Lee-F-Evans/Garden-Control-System/parts/1992Series5Specs.webp

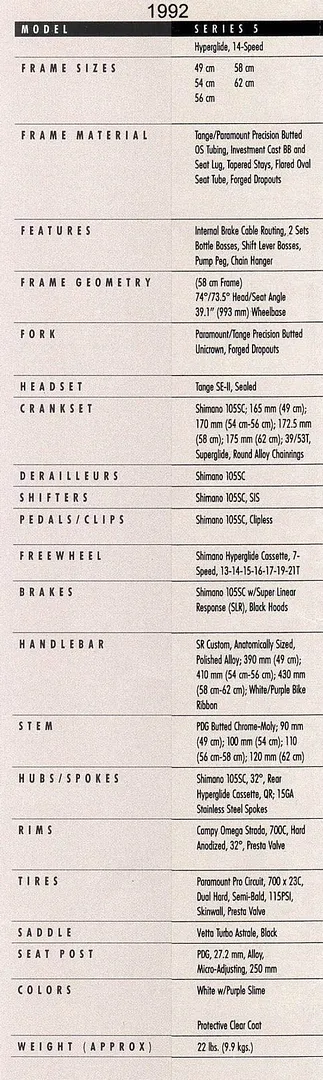
parts/1992Series5Specs.webp
