Lee-F-Evans/Garden-Control-System/3.3V buck LMR36520A.png

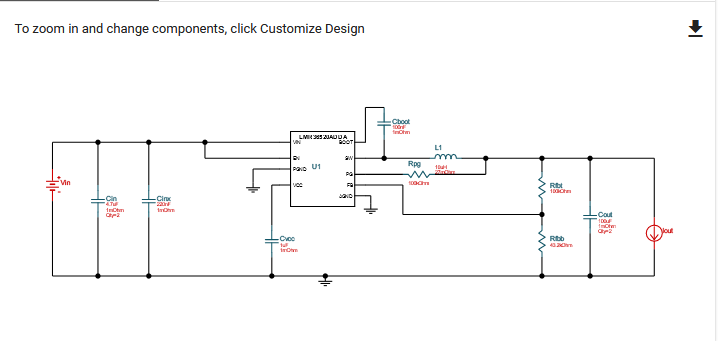
3.3V buck LMR36520A.png
