Lee-F-Evans/Garden-Control-System/3v0 ldo tps7A7001.png

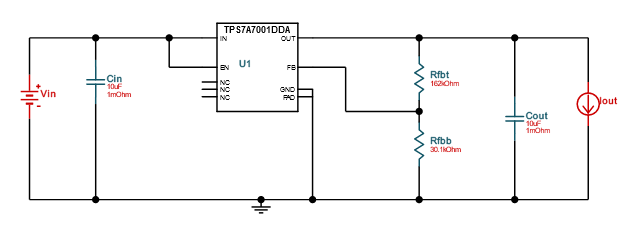
3v0 ldo tps7A7001.png
