Lee-F-Evans/Garden-Control-System/3V0 LDO TPS74901.png

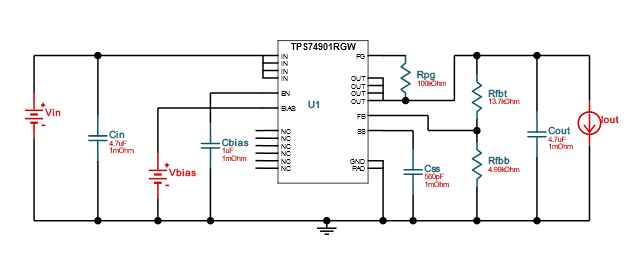
3V0 LDO TPS74901.png
