Lee-F-Evans/Garden-Control-System/LDO typical circuit.png

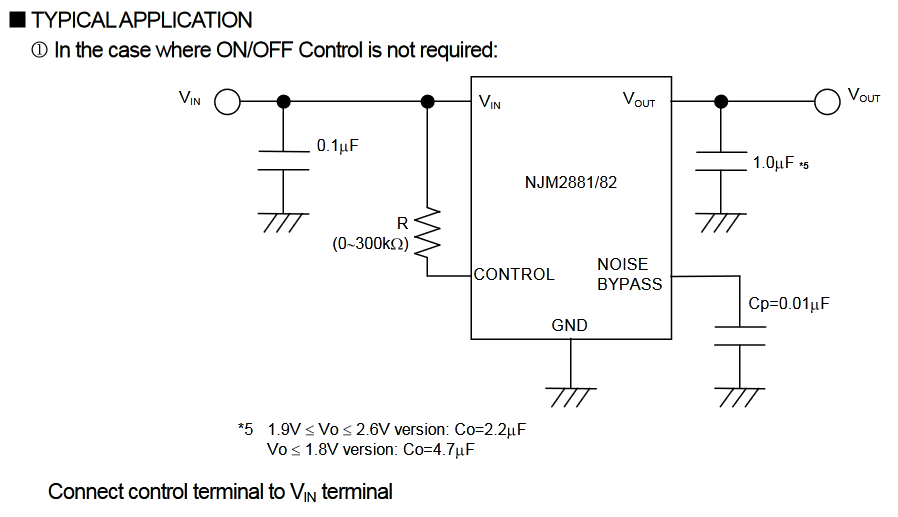
LDO typical circuit.png
