Lee-F-Evans/Garden-Control-System/LED RESISTOR VALUES FOR STRAPPING.png

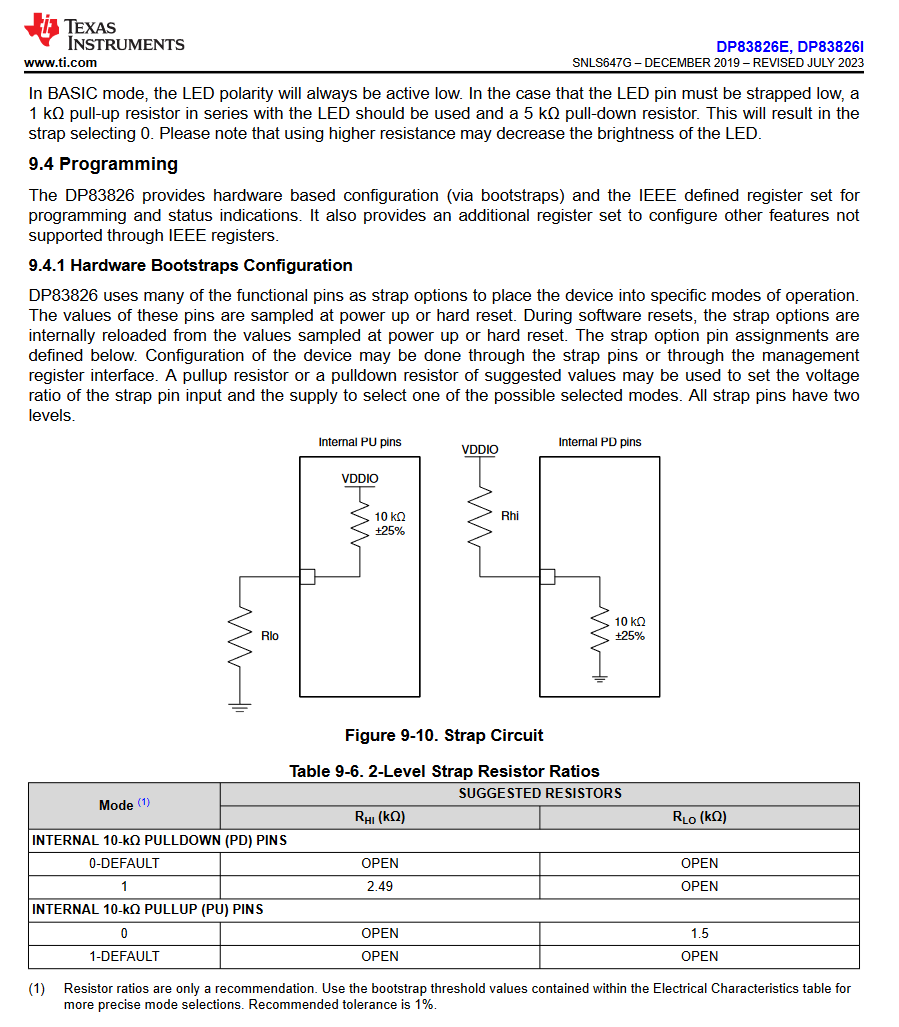
LED RESISTOR VALUES FOR STRAPPING.png
