Lee-F-Evans/Garden-Control-System/MCU_STM32F20x power info.png

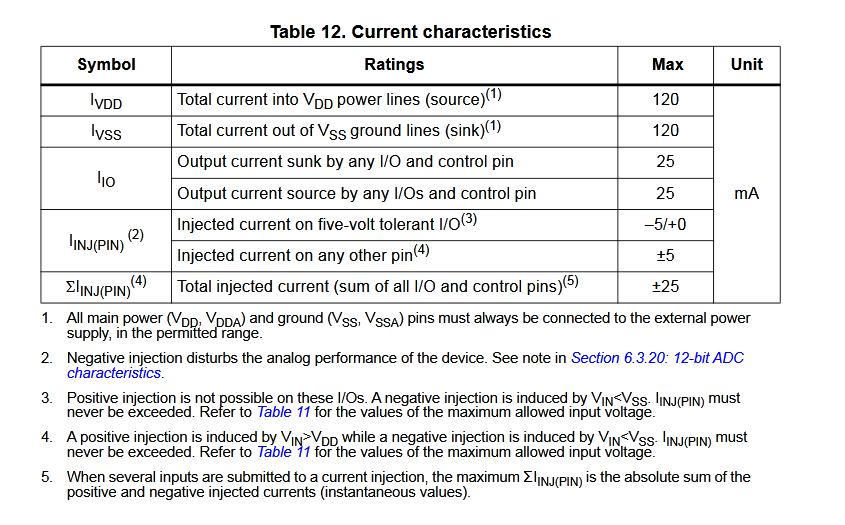
MCU_STM32F20x power info.png
