Lee-F-Evans/Garden-Control-System/MCU_STM32F205RG_pinout.png

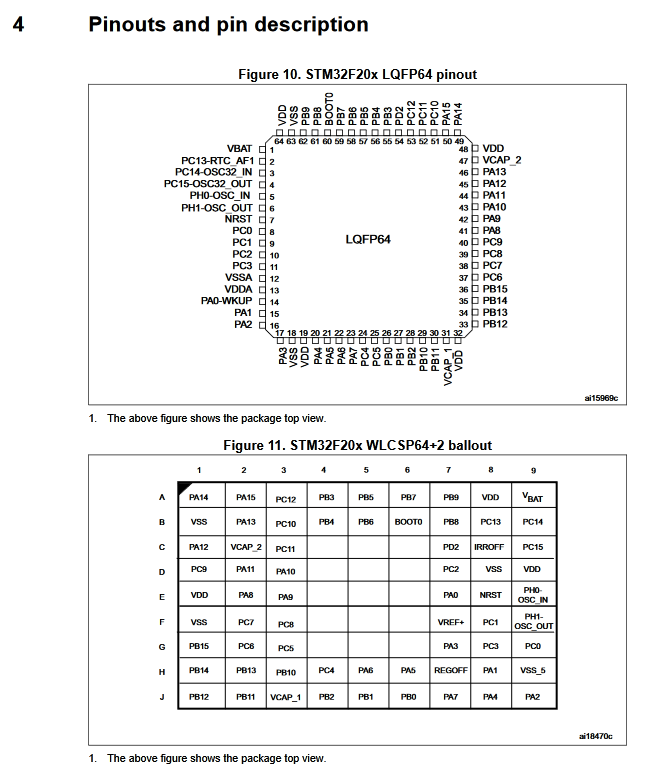
MCU_STM32F205RG_pinout.png
