Lee-F-Evans/Garden-Control-System/PHY strapping.png

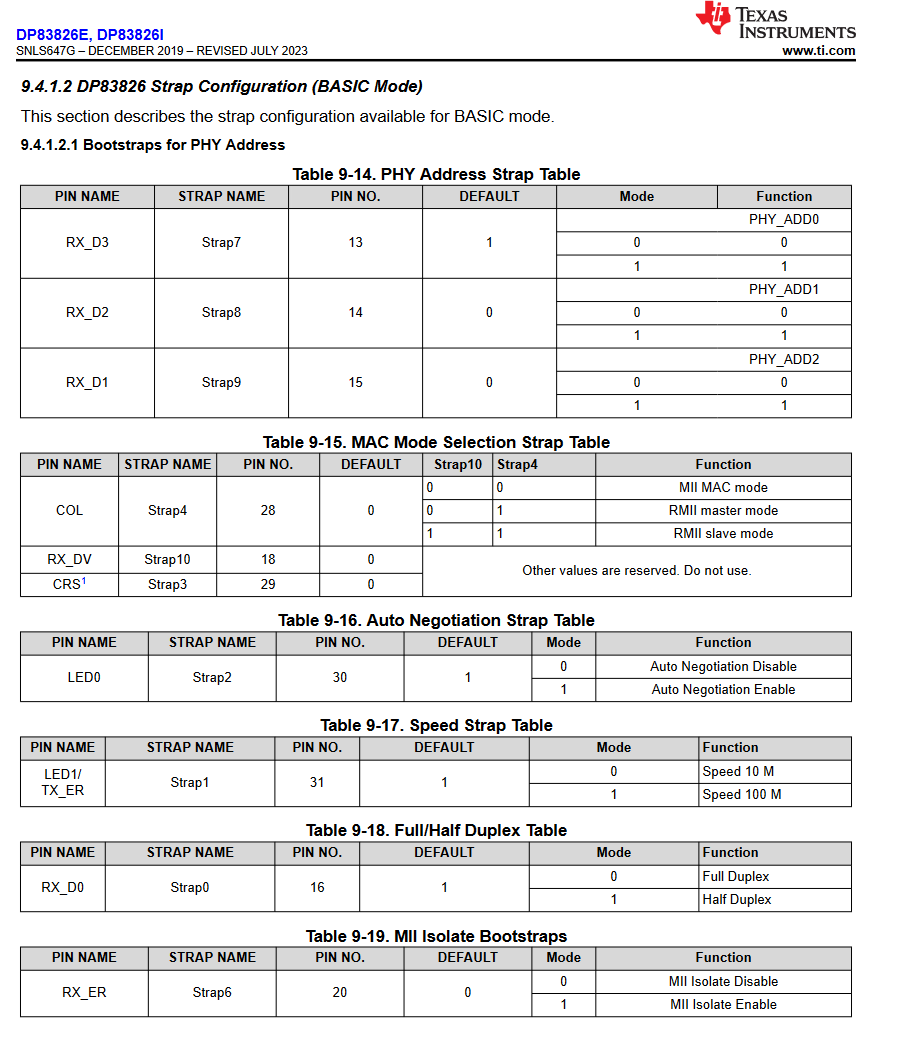
PHY strapping.png
