Lee-F-Evans/Garden-Control-System/Screenshot 2024-05-06 075731.png

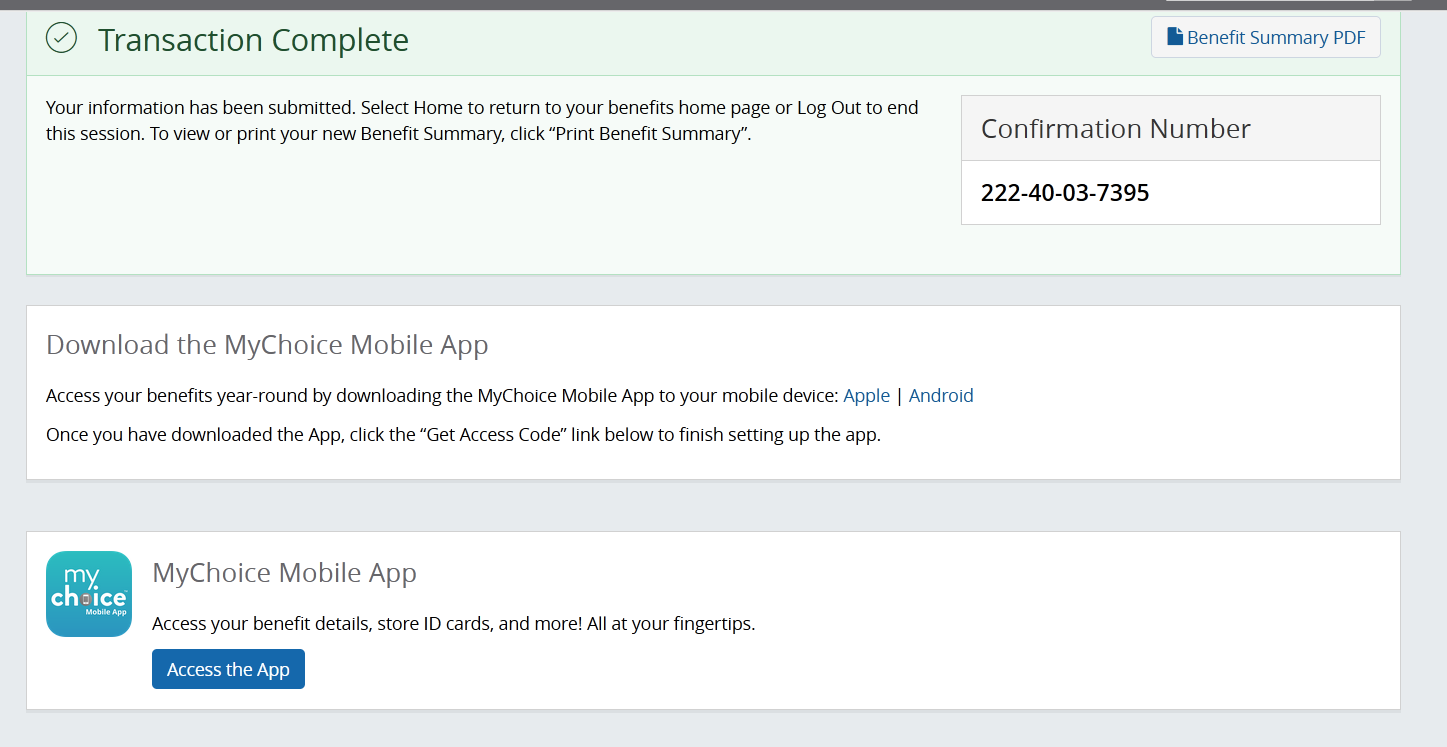
Screenshot 2024-05-06 075731.png
