Lee-F-Evans/Garden-Control-System/BOM.xlsx

1206, 100nF cap | https://www.digikey.ca/en/products/detail/samsung-electro-mechanics/CL31B104KBCNNNC/3886675
1206, 0.01uF cap | https://www.digikey.ca/en/products/detail/kemet/C1206C103KCRAC7800/721283
1206, 1uF cap | https://www.digikey.ca/en/products/detail/samsung-electro-mechanics/CL31B105KBHNNNE/3886726
1206 3KOhm resistor | https://www.digikey.ca/en/products/detail/yageo/RC1206FR-07300KL/728805
1206 ferrite bead | https://www.digikey.ca/en/products/detail/laird-signal-integrity-products/HI1206T500R-10/806649
