Lee-F-Evans/Garden-Control-System/parts/12V_5A_BarrelJack_pj-102ah/PJ-102AH.step

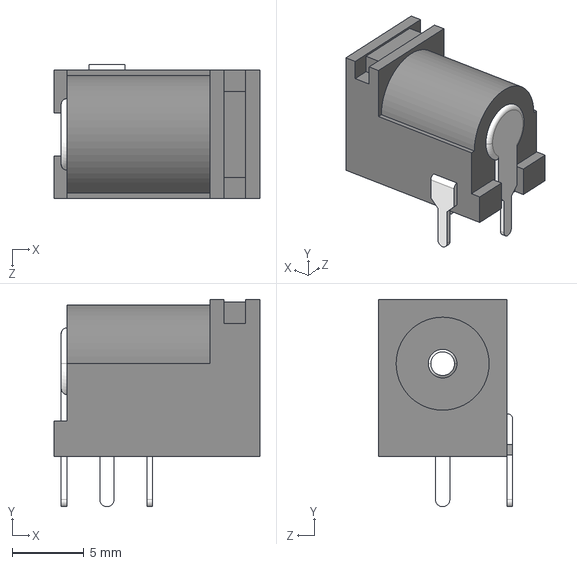
[picture p13: CAD file, 2024-04-08]
parts/12V_5A_BarrelJack_pj-102ah/PJ-102AH.step
14.4 x 14.5 x 9.40 mm
