Lee-F-Evans/Garden-Control-System/parts/3V3 LDO TPS7A7001DDAR/TPS7A7001DDAR.step

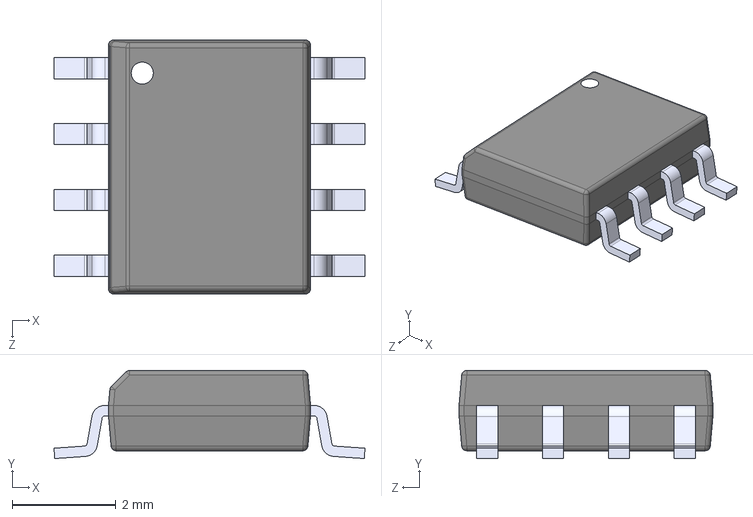
[picture p14: CAD file, 2024-04-23]
parts/3V3 LDO TPS7A7001DDAR/TPS7A7001DDAR.step
6.00 x 1.70 x 4.90 mm
