Lee-F-Evans/Garden-Control-System/parts/MCU_CRYSTAL_ECS_160_8_37_CWY_TR3/ECS-160-8-37-CWY-TR3.step

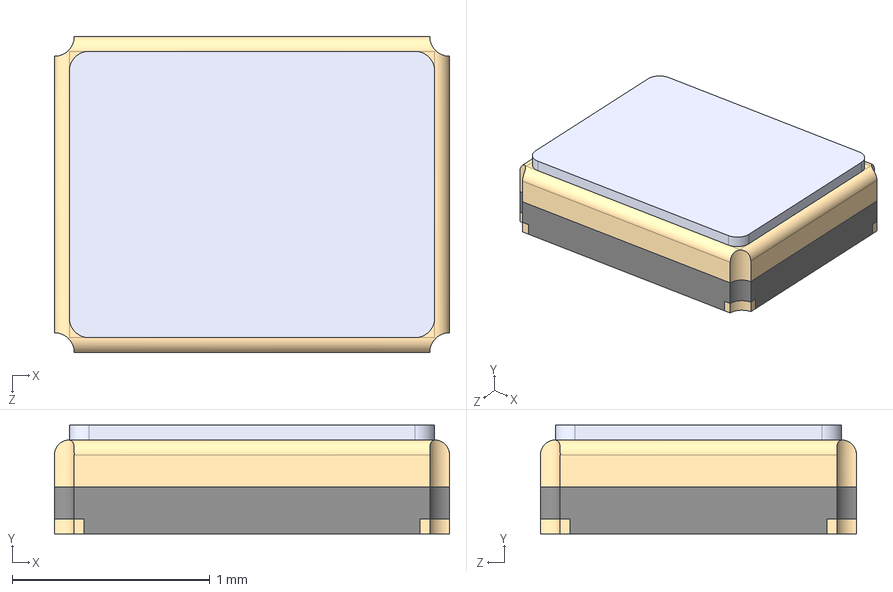
[picture p15: CAD file, 2024-04-08]
parts/MCU_CRYSTAL_ECS_160_8_37_CWY_TR3/ECS-160-8-37-CWY-TR3.step
2.00 x 0.55 x 1.60 mm
