Lee-F-Evans/Garden-Control-System/parts/MOTOR_DRIVER_DRV8848PWPR/DRV8848PWPR.step

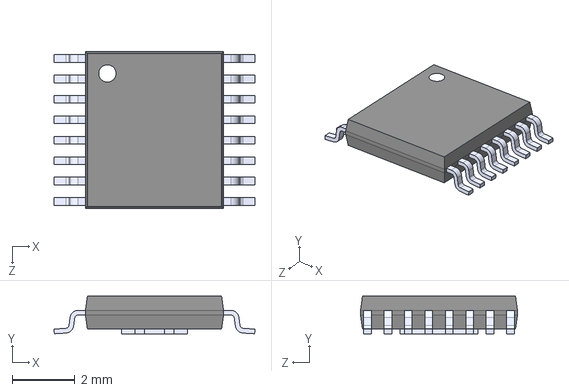
[picture p16: CAD file, 2024-04-08]
parts/MOTOR_DRIVER_DRV8848PWPR/DRV8848PWPR.step
6.40 x 1.20 x 5.00 mm
