Lee-F-Evans/Garden-Control-System/parts/PHY_CRYSTAL_ECS_250_20_33_TR/ECS-250-20-33-TR.step

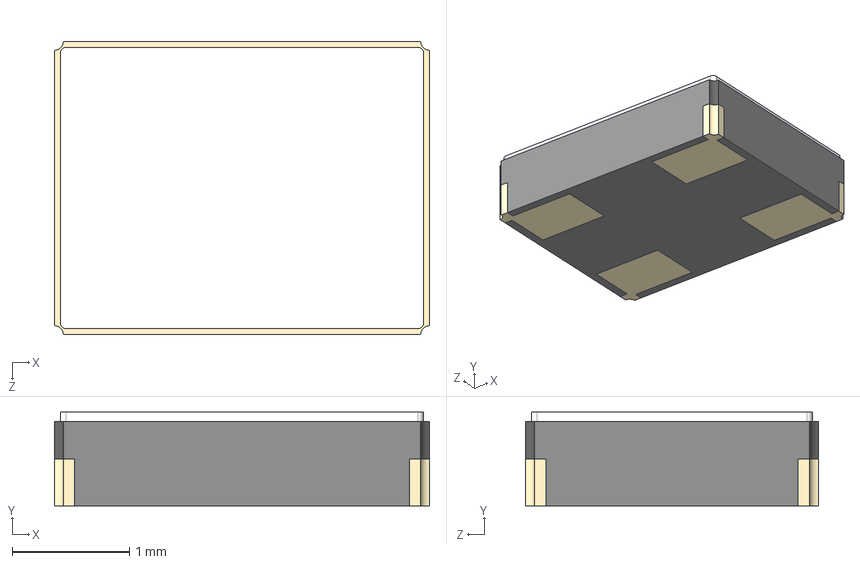
[picture p17: CAD file, 2024-04-08]
parts/PHY_CRYSTAL_ECS_250_20_33_TR/ECS-250-20-33-TR.step
3.20 x 0.8 x 2.50 mm
