Lee-F-Evans/Garden-Control-System/parts/POWER_NMOS_IRLML6344TRPBF/IRLML6344TRPBF.step

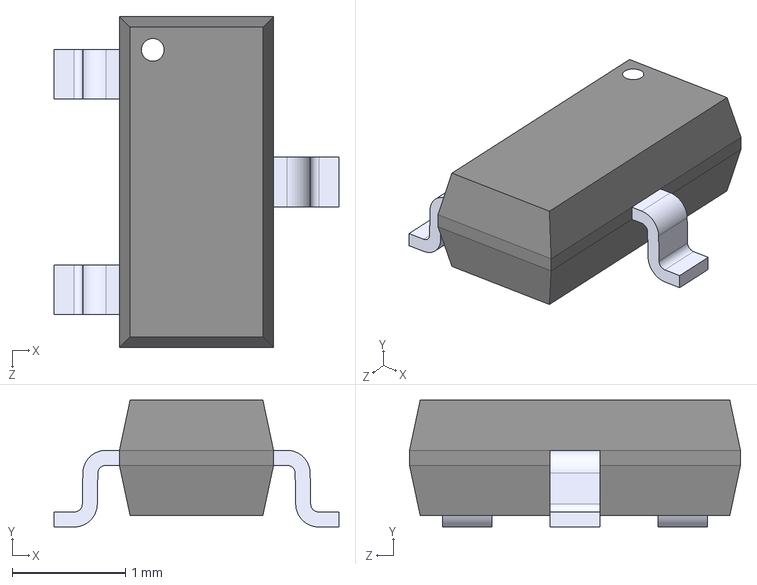
[picture p18: CAD file, 2024-04-09]
parts/POWER_NMOS_IRLML6344TRPBF/IRLML6344TRPBF.step
2.51 x 1.12 x 2.92 mm
