Lee-F-Evans/Garden-Control-System/parts/RJ45_RJHSE_5084/RJHSE-5084.step

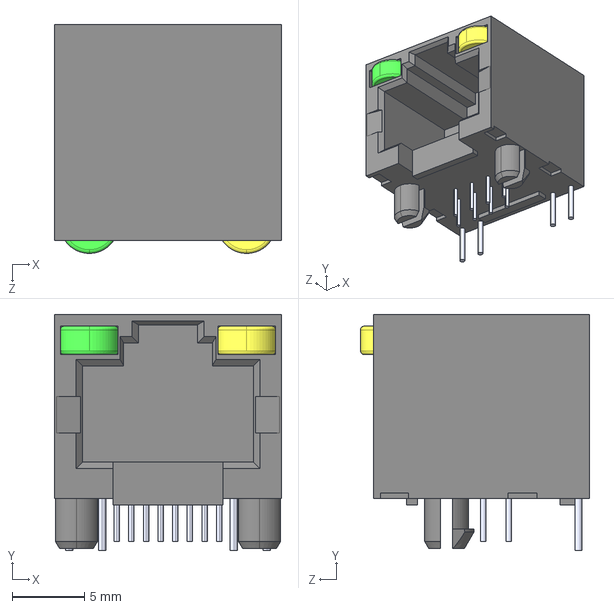
[picture p19: CAD file, 2024-04-08]
parts/RJ45_RJHSE_5084/RJHSE-5084.step
15.7 x 16.4 x 15.9 mm
