Lee-F-Evans/Garden-Control-System/parts/5V BUCK TPS54202HDDCR/TPS54202HDDCR.step

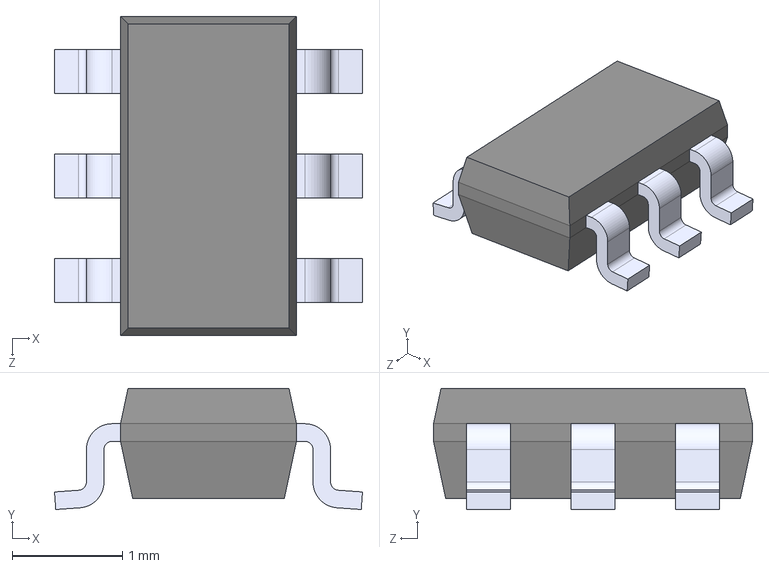
[picture p20: CAD file, 2024-04-23]
parts/5V BUCK TPS54202HDDCR/TPS54202HDDCR.step
2.80 x 1.10 x 2.90 mm
