Lee-F-Evans/Garden-Control-System/parts/PHY_DP83826IRHBR/DP83826IRHBR.step

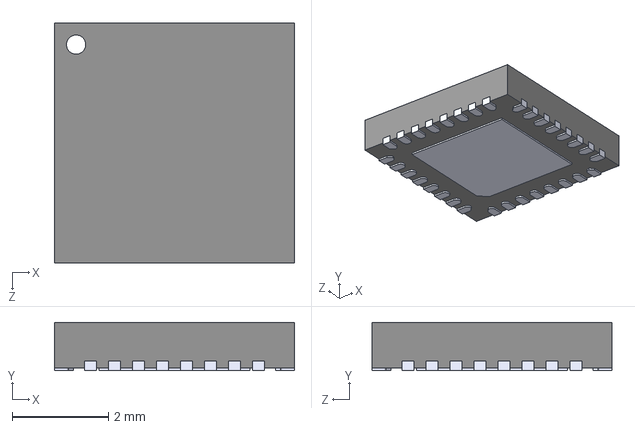
[picture p21: CAD file, 2024-04-08]
parts/PHY_DP83826IRHBR/DP83826IRHBR.step
5.00 x 1.00 x 5.00 mm
