Lee-F-Evans/Garden-Control-System/(list of files, cad)

Other CAD files:
parts/CUR_SENSE_INA4180A2IPWR/Concept/2024_04_08_20_24_48/exported/ina4180a2ipwr/chips/chips.prt
