Lee-F-Evans/Garden-Control-System/PHY and MAG wiring diagram.png

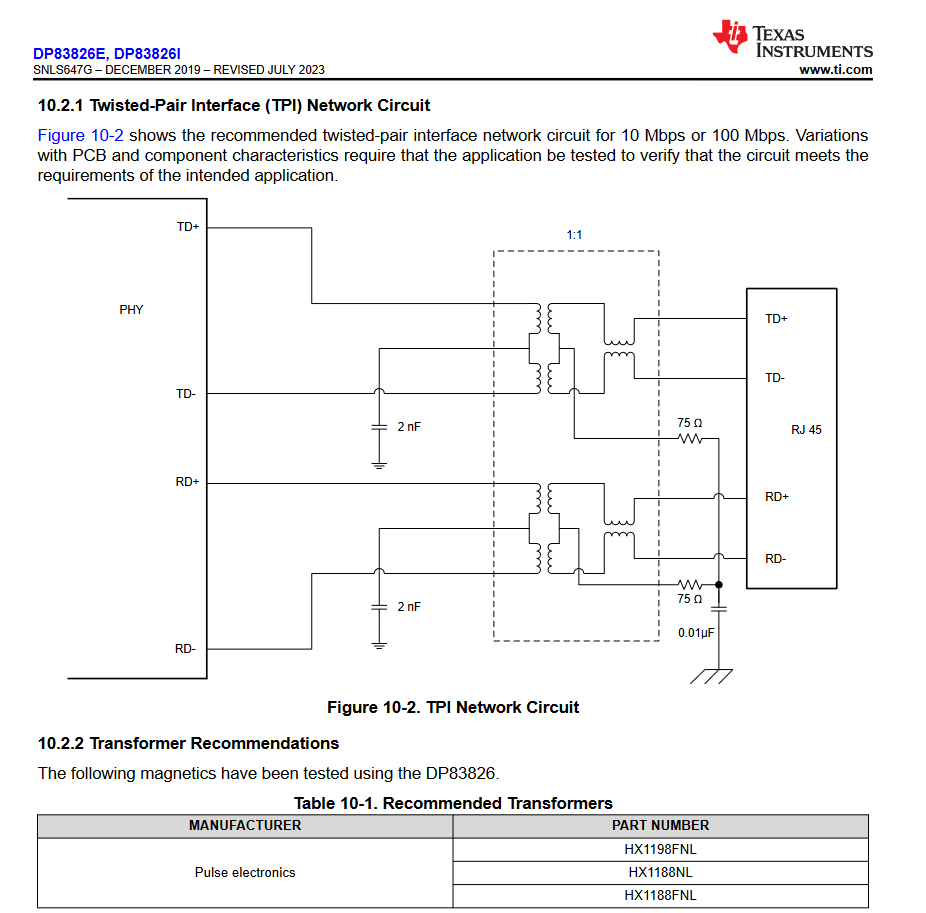
PHY and MAG wiring diagram.png
