Lee-F-Evans/Garden-Control-System/parts/RJ45_RJHSE-5084.pdf

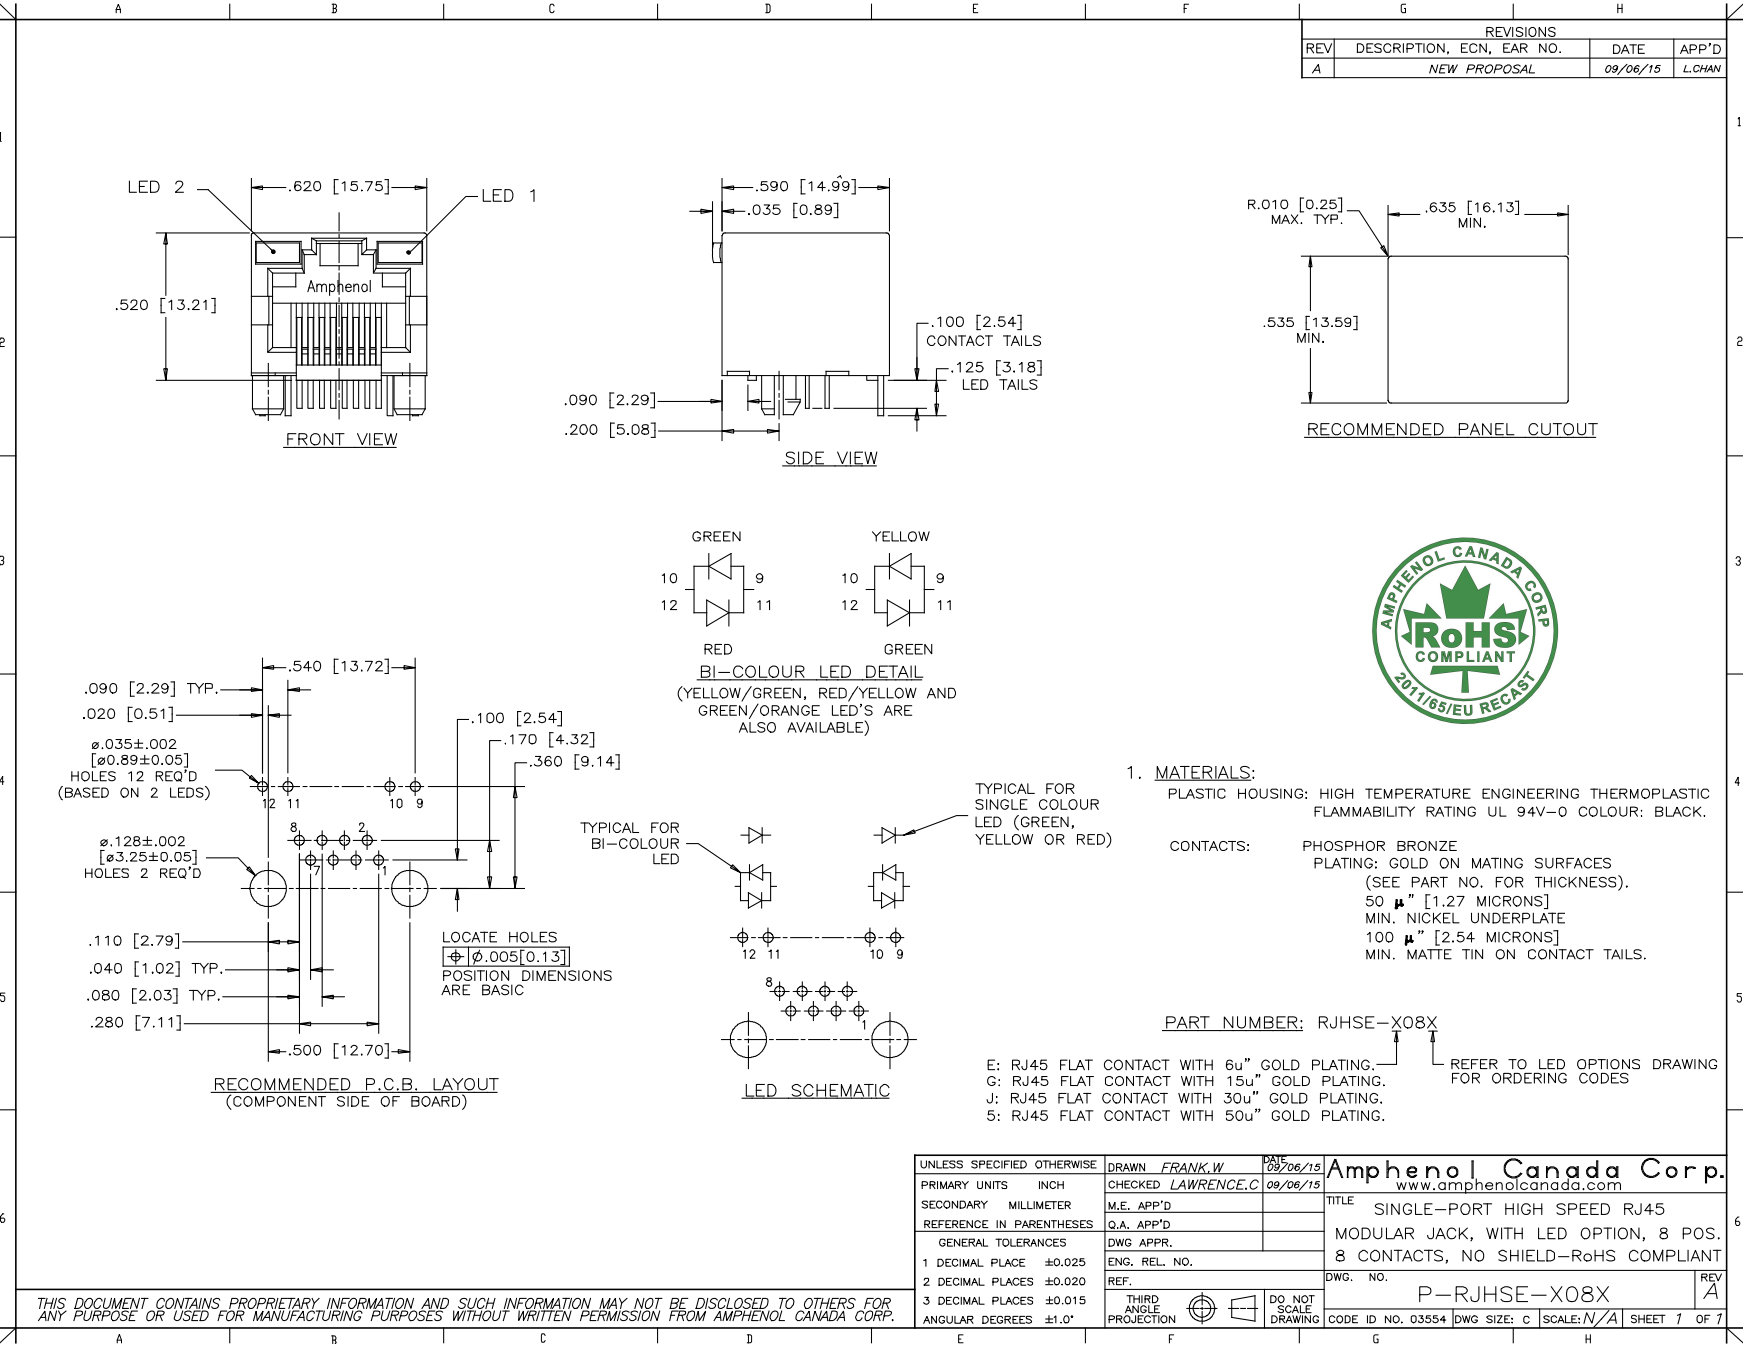
[picture p23: page 1]

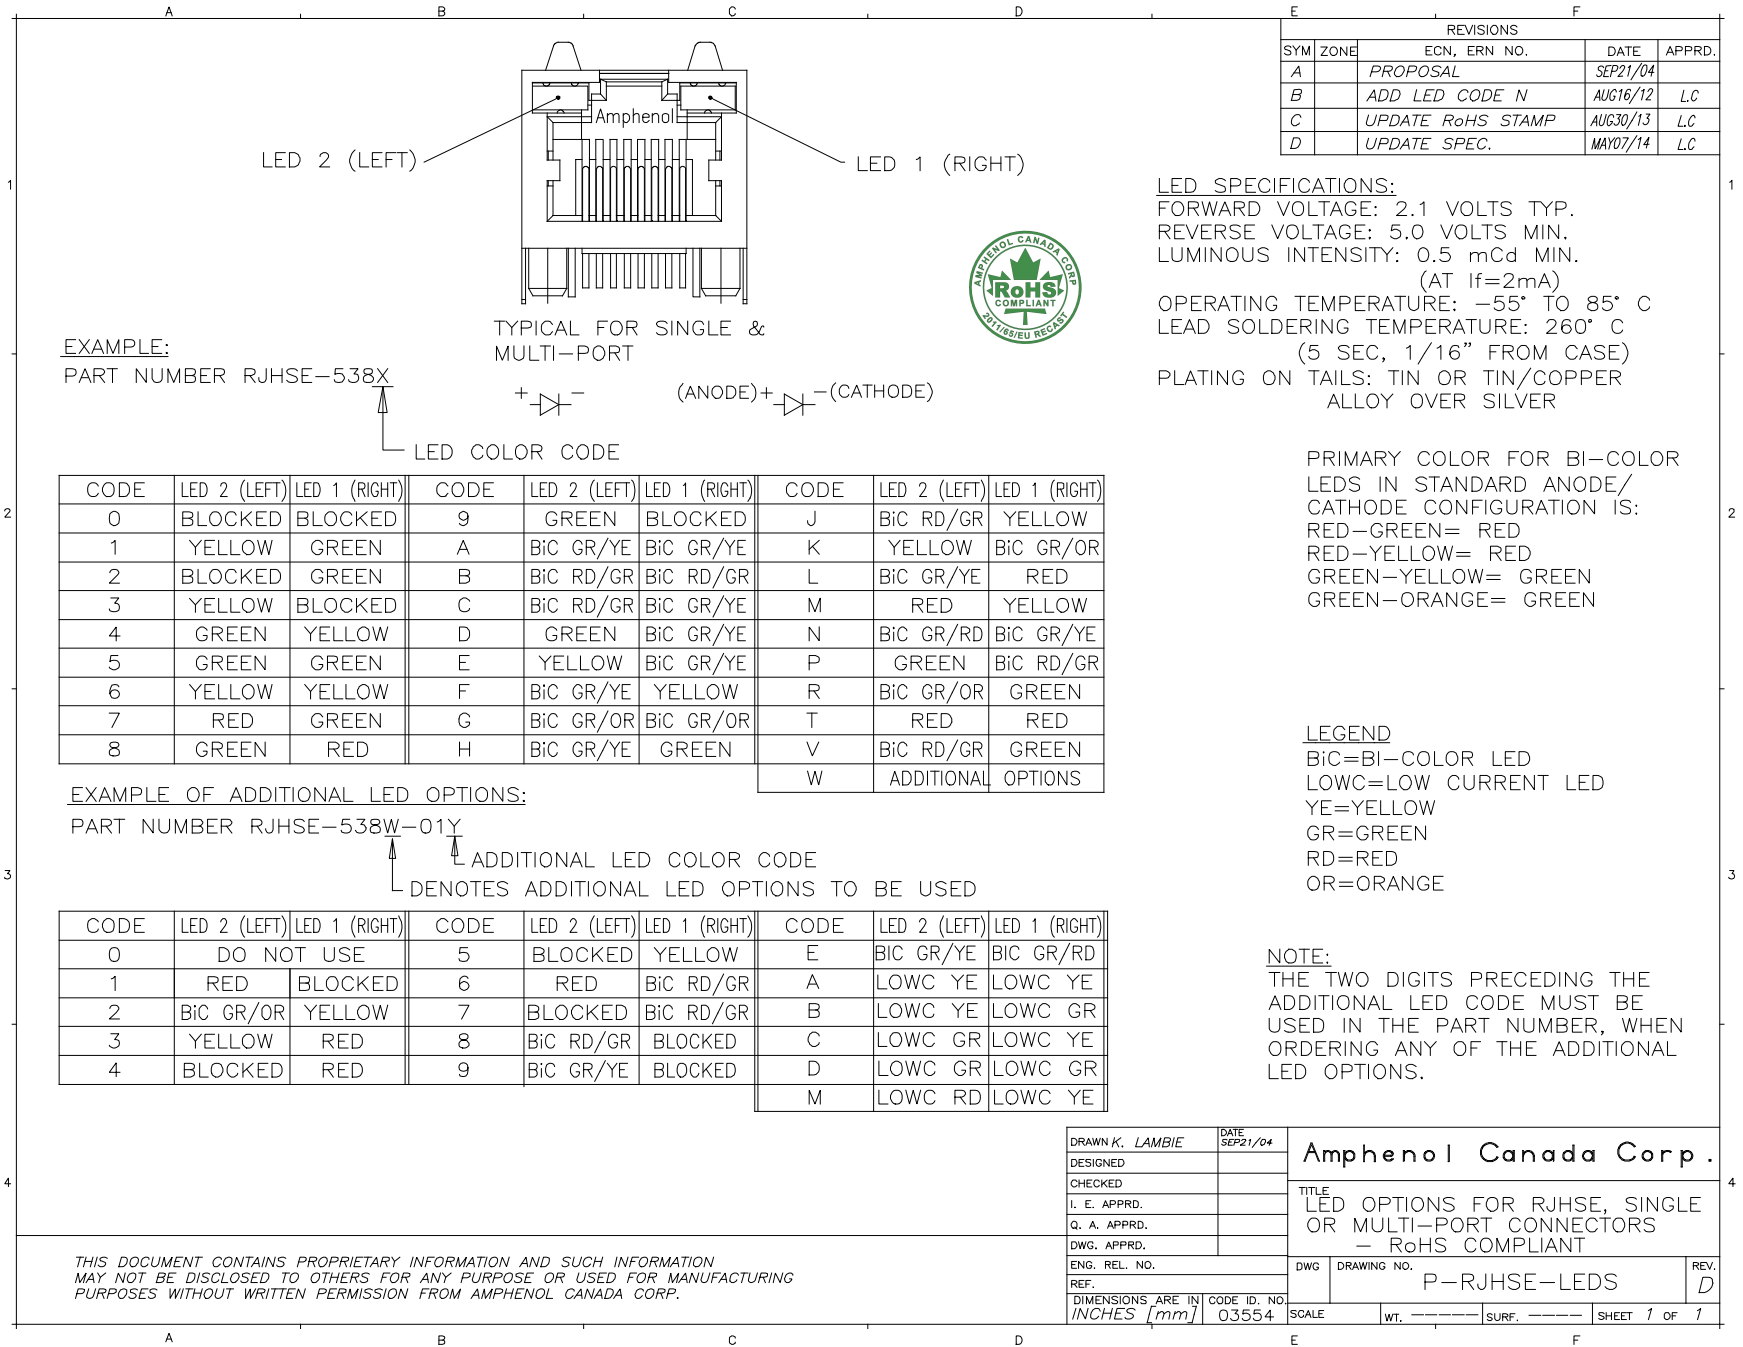
[picture p24: page 2]
