Lee-F-Evans/Garden-Control-System/KiCad files/Garden Control System/Connectors.kicad_sch

## KiCad design KiCad files/Garden Control System/Connectors.kicad_sch (2024-04-23, an earlier design)

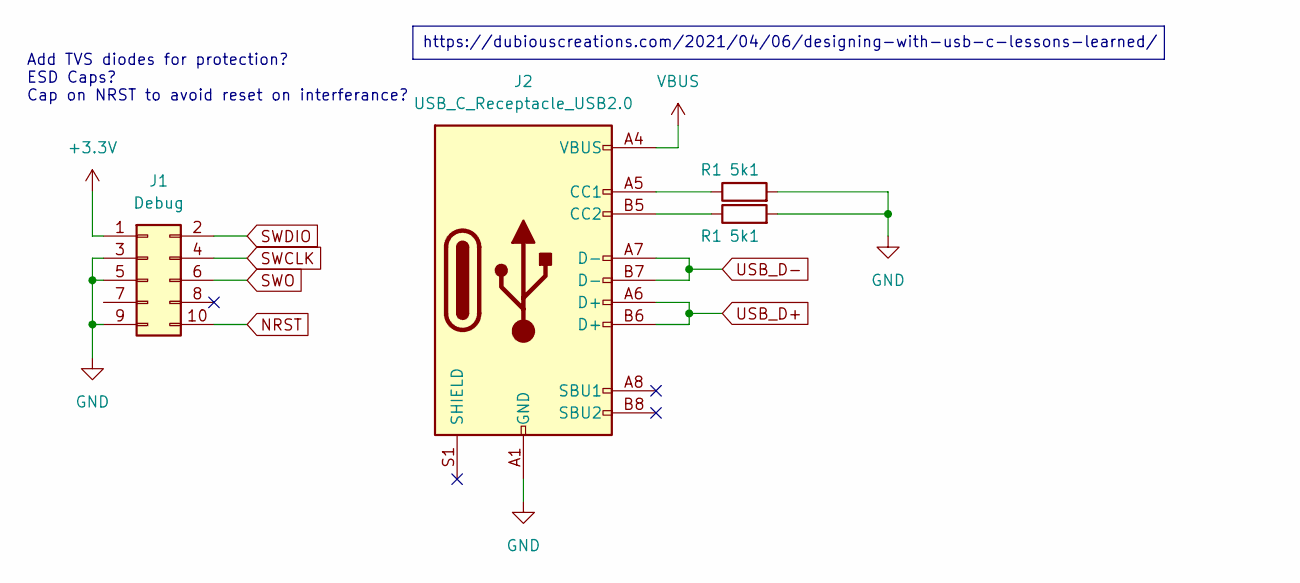
[picture p25: schematic Connectors.kicad_sch]

Parts:
J1: Debug
J2: USB_C_Receptacle_USB2.0
R1: 5k1

Connections:
+3.3V: J1.1
GND: J1.3, J1.5, J1.9, J2.A1 (GND), J2.A12 (GND), J2.B1 (GND), J2.B12 (GND), R1.2
NRST: J1.10
unnamed: J2.A5 (CC1), R1.1
unnamed: J2.B5 (CC2), R1.1
SWCLK: J1.4
SWDIO: J1.2
SWO: J1.6
USB_D+: J2.A6 (D+), J2.B6 (D+)
USB_D-: J2.A7 (D-), J2.B7 (D-)
VBUS: J2.A4 (VBUS), J2.A9 (VBUS), J2.B4 (VBUS), J2.B9 (VBUS)

Notes on the sheet:
https://dubiouscreations.com/2021/04/06/designing-with-usb-c-lessons-learned/
Add TVS diodes for protection? ESD Caps? Cap on NRST to avoid reset on interferance?
