Lee-F-Evans/Garden-Control-System/KiCad files/Garden Control System/Encoder and Display.kicad_sch

## KiCad design KiCad files/Garden Control System/Encoder and Display.kicad_sch (2024-04-26)

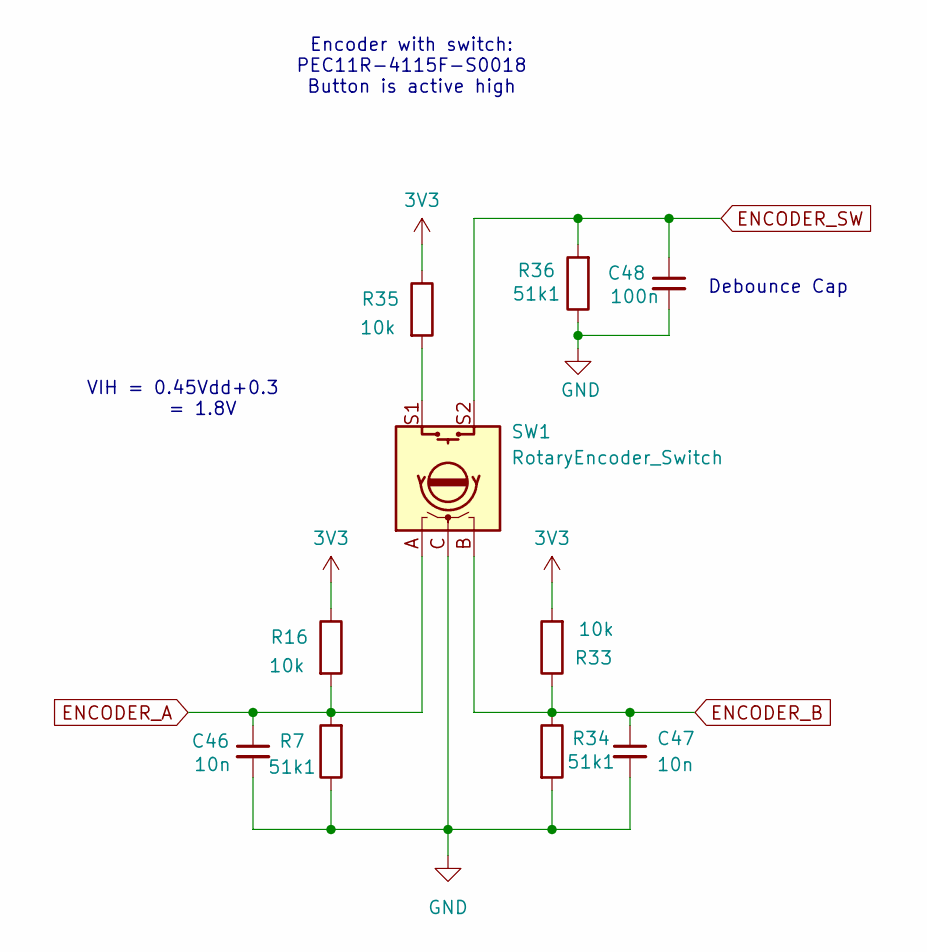
[picture p26: schematic Encoder and Display.kicad_sch]

Parts:
C46, C47: 10n
C48: 100n
R7, R34, R36: 51k1
R16, R33, R35: 10k
SW1: RotaryEncoder_Switch

Connections:
3V3: R16.1, R33.2, R35.1
ENCODER_A: C46.1, R7.2, R16.2, SW1.A
ENCODER_B: C47.1, R33.1, R34.1, SW1.B
ENCODER_SW: C48.1, R36.2, SW1.S2
GND: C46.2, C47.2, C48.2, R7.1, R34.2, R36.1, SW1.C
unnamed: R35.2, SW1.S1

Notes on the sheet:
Encoder with switch: PEC11R-4115F-S0018 Button is active high
Debounce Cap
VIH = 0.45Vdd+0.3 = 1.8V
