Lee-F-Evans/Garden-Control-System/KiCad files/Garden Control System/Ethernet.kicad_sch

## KiCad design KiCad files/Garden Control System/Ethernet.kicad_sch (2024-04-26, an earlier design)

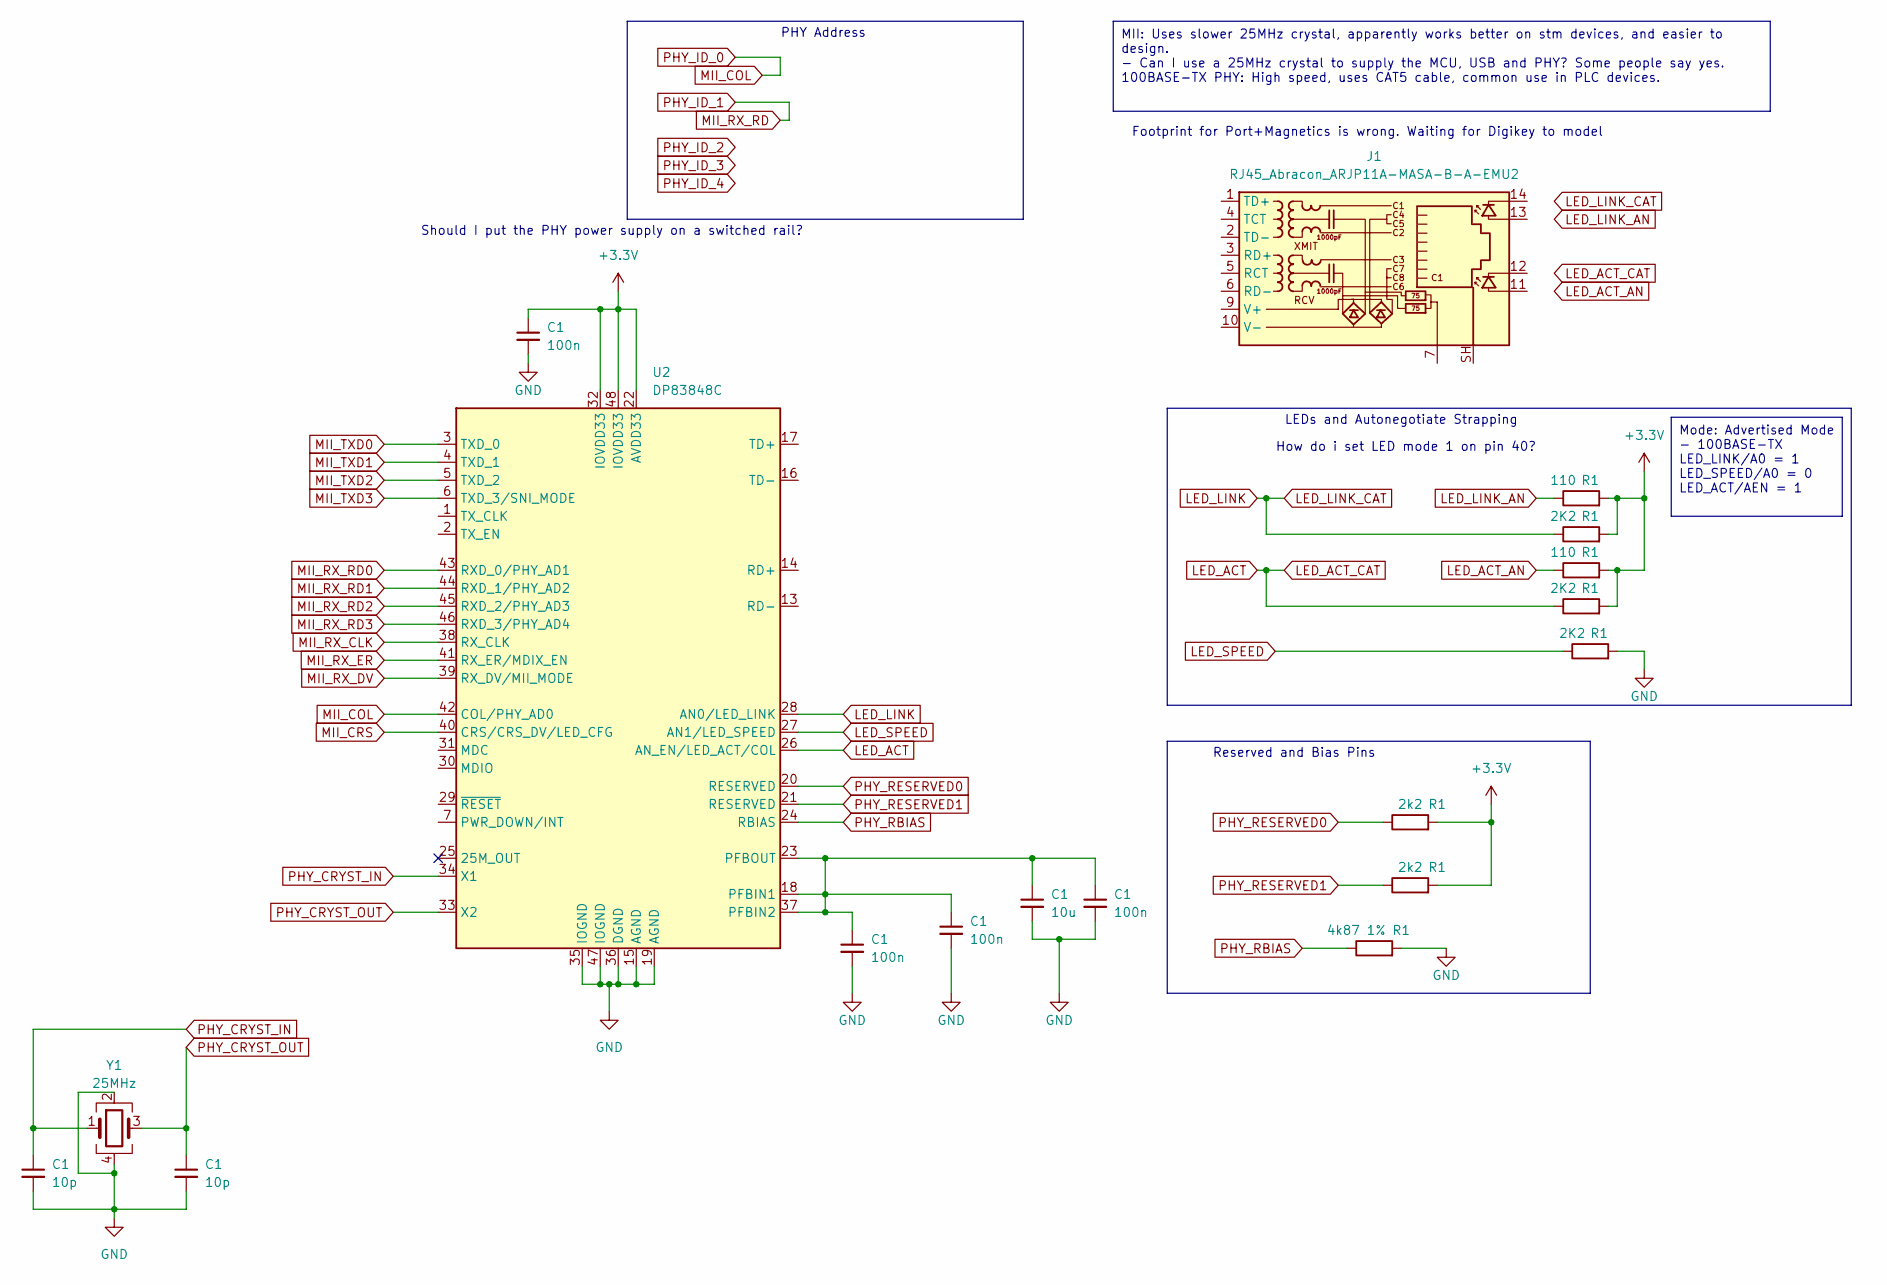
[picture p27: schematic Ethernet.kicad_sch]

Parts:
C1: 100n
J1: RJ45_Abracon_ARJP11A-MASA-B-A-EMU2; RJ45_Abracon_ARJP11A-MA_Horizontal
R1: 2K2
U2: DP83848C; LQFP-48_7x7mm_P0.5mm
Y1: 25MHz

Connections:
+3.3V: C1.1, R1.2, U2.22 (AVDD33), U2.32 (IOVDD33), U2.48 (IOVDD33)
GND: C1.2, R1.2, U2.15 (AGND), U2.19 (AGND), U2.35 (IOGND), U2.36 (DGND), U2.47 (IOGND), Y1.2, Y1.4
LED_ACT: R1.1, U2.26 (AN_EN/LED_ACT/COL)
LED_ACT_AN: R1.1
LED_LINK: R1.1, U2.28 (AN0/LED_LINK)
LED_LINK_AN: R1.1
LED_SPEED: R1.1, U2.27 (AN1/LED_SPEED)
MII_COL: U2.42 (COL/PHY_AD0)
MII_CRS: U2.40 (CRS/CRS_DV/LED_CFG)
MII_RX_CLK: U2.38 (RX_CLK)
MII_RX_DV: U2.39 (RX_DV/MII_MODE)
MII_RX_ER: U2.41 (RX_ER/MDIX_EN)
MII_RX_RD0: U2.43 (RXD_0/PHY_AD1)
MII_RX_RD1: U2.44 (RXD_1/PHY_AD2)
MII_RX_RD2: U2.45 (RXD_2/PHY_AD3)
MII_RX_RD3: U2.46 (RXD_3/PHY_AD4)
MII_TXD0: U2.3 (TXD_0)
MII_TXD1: U2.4 (TXD_1)
MII_TXD2: U2.5 (TXD_2)
MII_TXD3: U2.6 (TXD_3/SNI_MODE)
unnamed: C1.1, U2.18 (PFBIN1), U2.23 (PFBOUT), U2.37 (PFBIN2)
PHY_CRYST_IN: C1.1, U2.34 (X1), Y1.1
PHY_CRYST_OUT: C1.1, U2.33 (X2), Y1.3
PHY_RBIAS: R1.1, U2.24 (RBIAS)
PHY_RESERVED0: R1.1, U2.20 (RESERVED)
PHY_RESERVED1: R1.1, U2.21 (RESERVED)

Notes on the sheet:
Mode: Advertised Mode - 100BASE-TX LED_LINK/A0 = 1 LED_SPEED/A0 = 0 LED_ACT/AEN = 1
MII: Uses slower 25MHz crystal, apparently works better on stm devices, and easier to design. - Can I use a 25MHz crystal to supply the MCU, USB and PHY? Some people say yes. 100BASE-TX PHY: High speed, uses CAT5 cable, common use in PLC devices.
Reserved and Bias Pins
How do i set LED mode 1 on pin 40?
PHY Address
LEDs and Autonegotiate Strapping
Should I put the PHY power supply on a switched rail?
Footprint for Port+Magnetics is wrong. Waiting for Digikey to model
