Lee-F-Evans/Garden-Control-System/KiCad files/Garden Control System/MCU.kicad_sch

## KiCad design KiCad files/Garden Control System/MCU.kicad_sch (2024-07-29, an earlier design)

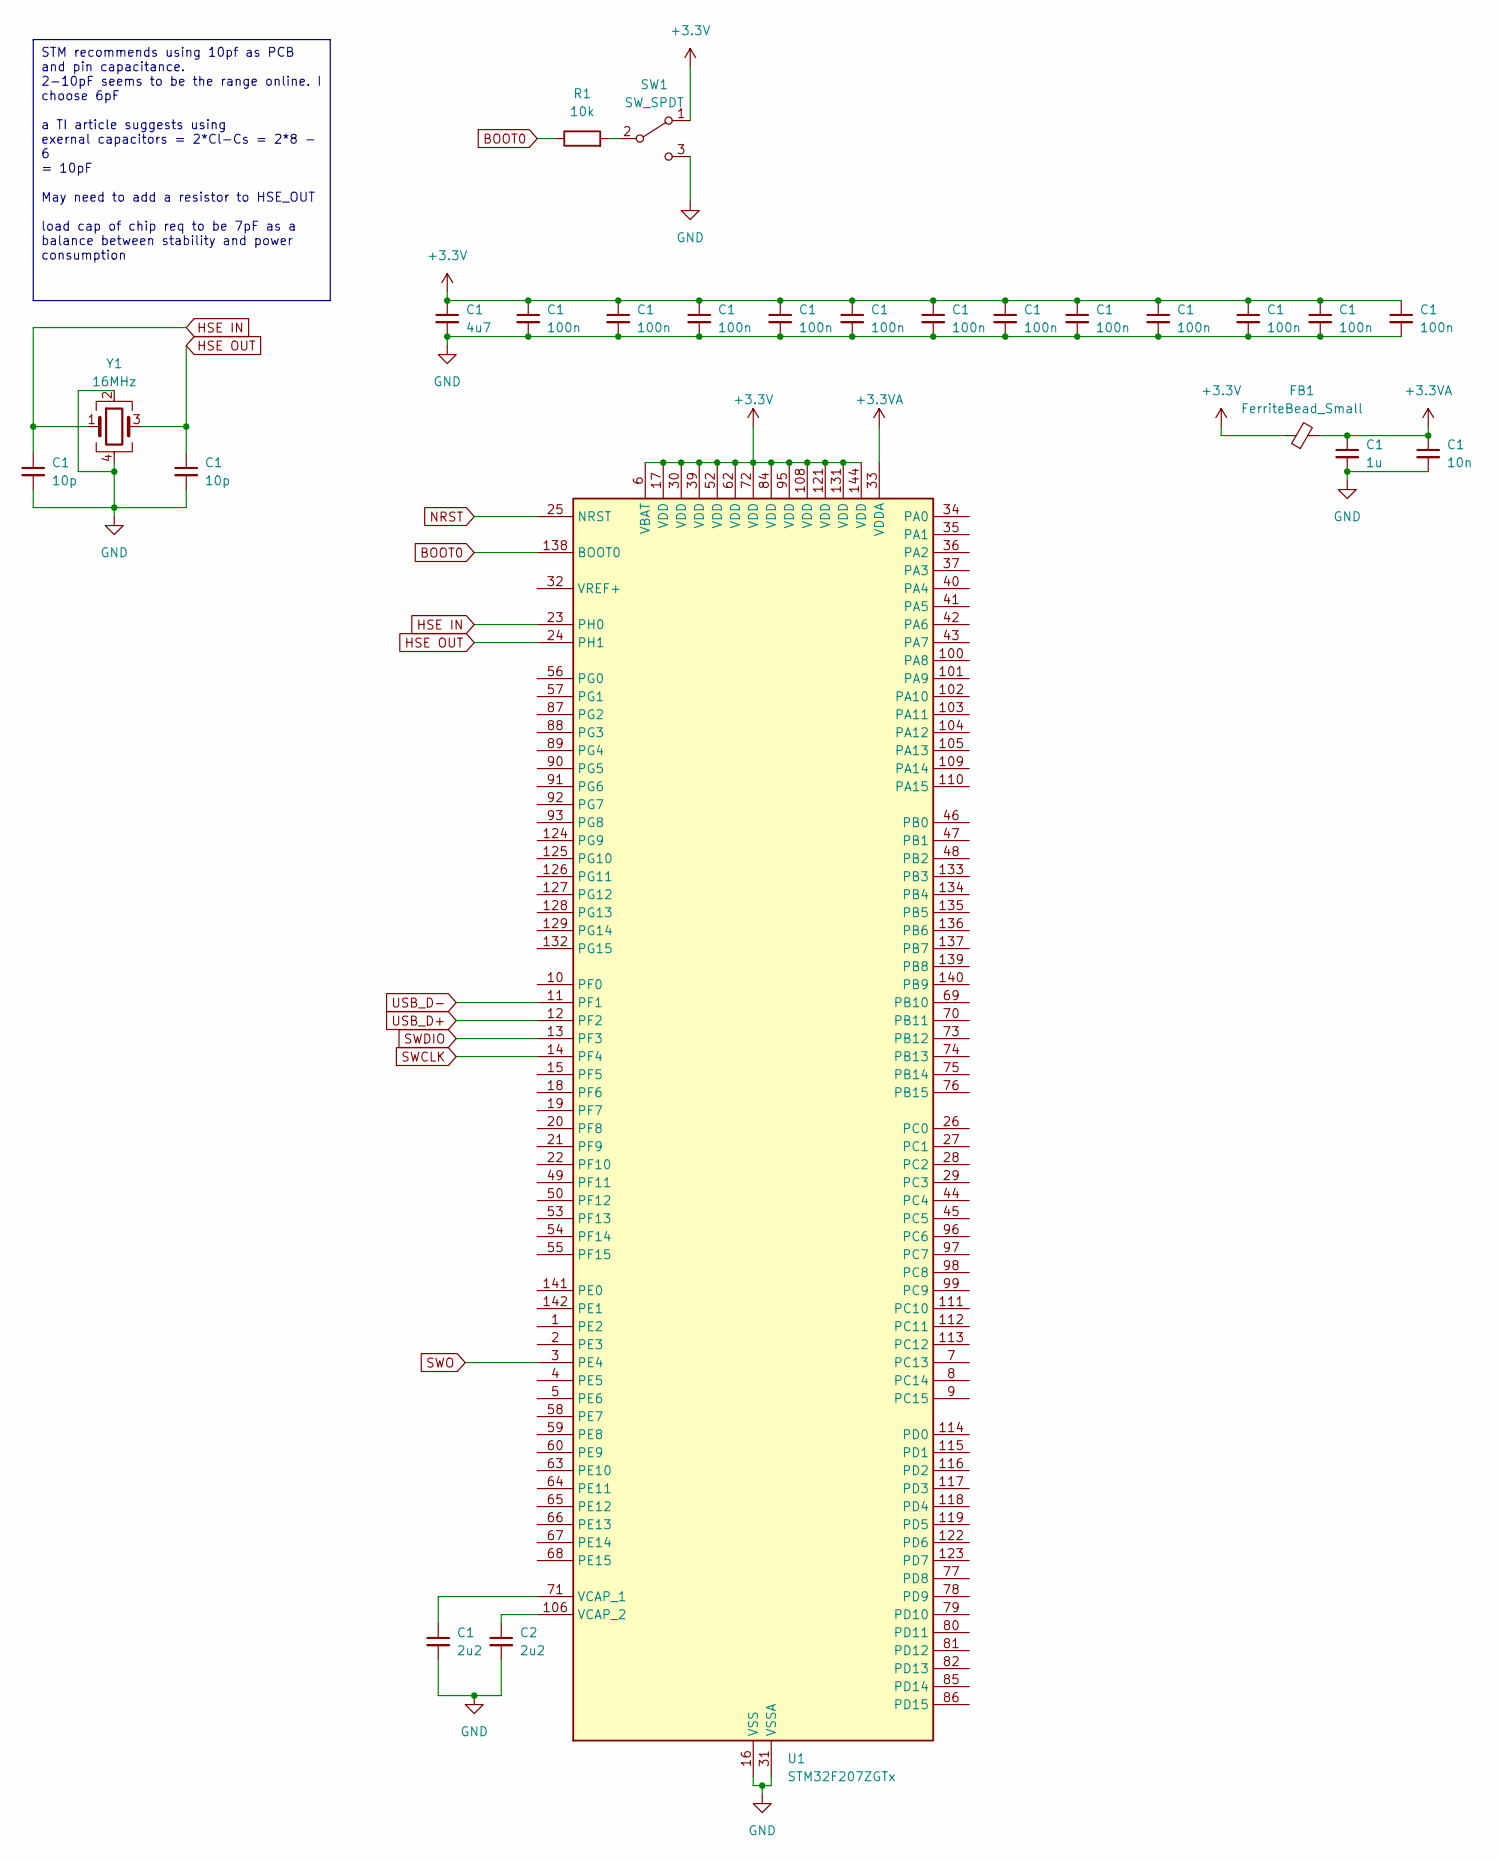
[picture p28: schematic MCU.kicad_sch]

Parts:
C1: 100n
C2: 2u2
FB1: FerriteBead_Small
R1: 10k
SW1: SW_SPDT
U1: STM32F207ZGTx; LQFP-144_20x20mm_P0.5mm
Y1: 16MHz

Connections:
+3.3V: C1.1, FB1.1, SW1.1 (A), U1.6 (VBAT), U1.17 (VDD), U1.30 (VDD), U1.39 (VDD), U1.52 (VDD), U1.62 (VDD), U1.72 (VDD), U1.84 (VDD), U1.95 (VDD), U1.108 (VDD), U1.121 (VDD), U1.131 (VDD), U1.144 (VDD)
+3.3VA: C1.1, FB1.2, U1.33 (VDDA)
BOOT0: R1.1, U1.138 (BOOT0)
GND: C1.2, C2.2, SW1.3 (C), U1.16 (VSS), U1.31 (VSSA), U1.38 (VSS), U1.51 (VSS), U1.61 (VSS), U1.83 (VSS), U1.94 (VSS), U1.107 (VSS), U1.120 (VSS), U1.130 (VSS), Y1.2, Y1.4
HSE IN: C1.1, U1.23 (PH0), Y1.1
HSE OUT: C1.1, U1.24 (PH1), Y1.3
NRST: U1.25 (NRST)
unnamed: C1.1, U1.71 (VCAP_1)
unnamed: C2.1, U1.106 (VCAP_2)
unnamed: R1.2, SW1.2 (B)
SWCLK: U1.14 (PF4)
SWDIO: U1.13 (PF3)
SWO: U1.3 (PE4)
USB_D+: U1.12 (PF2)
USB_D-: U1.11 (PF1)

Notes on the sheet:
STM recommends using 10pf as PCB and pin capacitance. 2-10pF seems to be the range online. I choose 6pF a TI article suggests using exernal capacitors = 2*Cl-Cs = 2*8 - 6 = 10pF May need to add a resistor to HSE_OUT load cap of chip req to be 7pF as a balance between stability and power consumption
