Lee-F-Evans/Garden-Control-System/STMcube/garden_control_system.ioc

Mcu.UserName=STM32F207ZGTx
PA0-WKUP.Signal=ETH_CRS
PA1.Signal=ETH_RX_CLK
PA11.Signal=USB_OTG_FS_DM
PA12.Signal=USB_OTG_FS_DP
PA13.Signal=SYS_JTMS-SWDIO
PA14.Signal=SYS_JTCK-SWCLK
PA2.Signal=ETH_MDIO
PA3.Signal=ETH_COL
PA7.Signal=ETH_RX_DV
PB0.Signal=ETH_RXD2
PB1.Signal=ETH_RXD3
PB11.Signal=ETH_TX_EN
PB12.Signal=ETH_TXD0
PB13.Signal=ETH_TXD1
PB3.Signal=SYS_JTDO-SWO
PC1.Signal=ETH_MDC
PC2.Signal=ETH_TXD2
PC3.Signal=ETH_TX_CLK
PC4.Signal=ETH_RXD0
PC5.Signal=ETH_RXD1
PD12.Signal=S_TIM4_CH1
PD13.Signal=S_TIM4_CH2
PD14.Signal=S_TIM4_CH3
PE11.Signal=S_TIM1_CH2
PE2.Signal=ETH_TXD3
PE9.Signal=S_TIM1_CH1
PF6.GPIO_Label=I_SENSE0
PF6.Signal=ADC3_IN4
PF7.GPIO_Label=I_SENSE1
PF7.Signal=ADC3_IN5
PF8.GPIO_Label=I_SENSE2
PF8.Signal=ADC3_IN6
PF9.GPIO_Label=I_SENSE3
PF9.Signal=ADC3_IN7
PH0-OSC_IN.Signal=RCC_OSC_IN
PH1-OSC_OUT.Signal=RCC_OSC_OUT
