Lee-F-Evans/Garden-Control-System/(commit log)

2024-04-07 Add files via upload
    First upload
    [BOM.xlsx, Connectors.kicad_sch, Ethernet.kicad_sch, Garden Control System.kicad_pcb, Garden Control System.kicad_sch, MCU.kicad_sch, Power.kicad_sch, Sensors and HSDs.kicad_sch]
2024-04-08 Close to finishing ethernet side
    [Connectors.kicad_sch, DP83826IRHBR.step, DRV8848PWPR.step, ECS-160-8-37-CWY-TR3.step, ECS-250-20-33-TR.step, Ethernet.kicad_sch, Garden Control System.kicad_sch, MCU.kicad_sch]
2024-04-08 working on power arch
    [Connectors.kicad_sch, Ethernet.kicad_sch, MCU.kicad_sch, PJ-102AH.step, Power.kicad_sch, Sensors and HSDs.kicad_sch, chips.prt]
2024-04-09 working on gate driver circuit for motor control
    [Power.kicad_sch, Sensors and HSDs.kicad_sch]
2024-04-09 expanded power supply section. completed LSD design. sized shunt resistors
    [Connectors.kicad_sch, Garden Control System.kicad_sch, IRLML6344TRPBF.step, MCU.kicad_sch, Power.kicad_sch, Sensors and HSDs.kicad_sch, TPS62933PDRLR.step]
2024-04-23 adding recent schematic progress
    [Connectors.kicad_sch, Ethernet.kicad_sch, Garden Control System.kicad_sch, MCU.kicad_sch, Power.kicad_sch, Sensors and HSDs.kicad_sch, TPS54202HDDCR.step, TPS62933PDRLR.step]
2024-04-26 working on temp sensor circuit
    [Encoder and Display.kicad_sch, Ethernet.kicad_sch, Garden Control System.kicad_sch, MCU.kicad_sch, Power.kicad_sch, Sensors and HSDs.kicad_sch, Temperature Sensors.kicad_sch]
2024-04-29 added more info to temp section
    [Just NTC data.xlsx, NTC RT Calculation Vishay_NTCS0402E3103HHT.csv, Temperature Sensors.kicad_sch]
2024-07-29 Added a basic readme
    [MCU.kicad_sch, Power.kicad_sch]
